openenergymonitor/emontx5/readme.md

# EmonTx5

EmonTx5, 6 channel energy monitoring transmitter based on emonPi2 measurement board.
