openenergymonitor/emontx5/docs/hardware.md

---
github_url: "https://github.com/openenergymonitor/emontx5/blob/main/docs/hardware.md"
---

# Hardware

The emonTx5 uses the same measurement board as the emonPi2. The only hardware differences are that the emonTx5 does not include the OLED display, push button, and an attached Raspberry Pi. Its radio module is configured through software to transmit data, rather than receive it, thereby making it an electricity monitoring transmitter node.

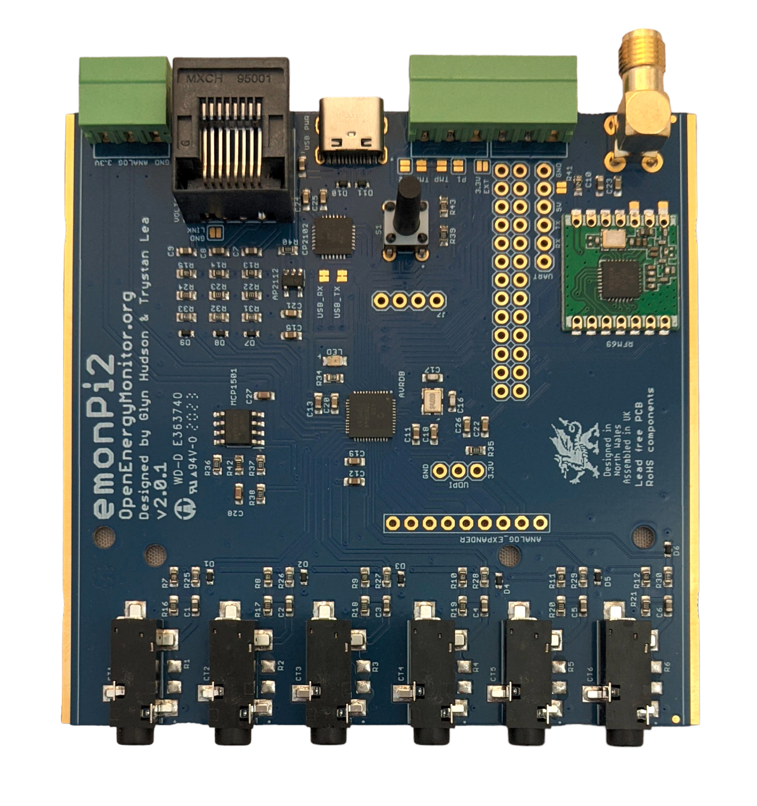
[picture p2: docs/img/emonpi2_board.jpg]


## Schematic

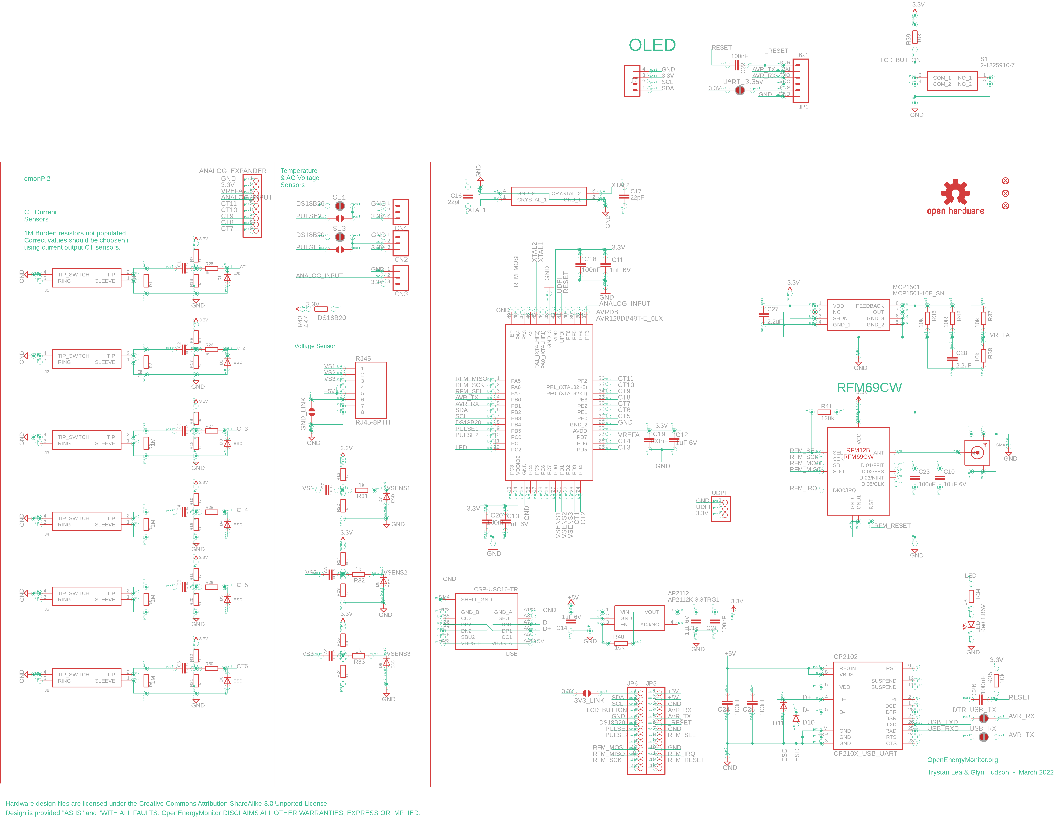
[picture p3: docs/img/schematic.png]


## Board layout

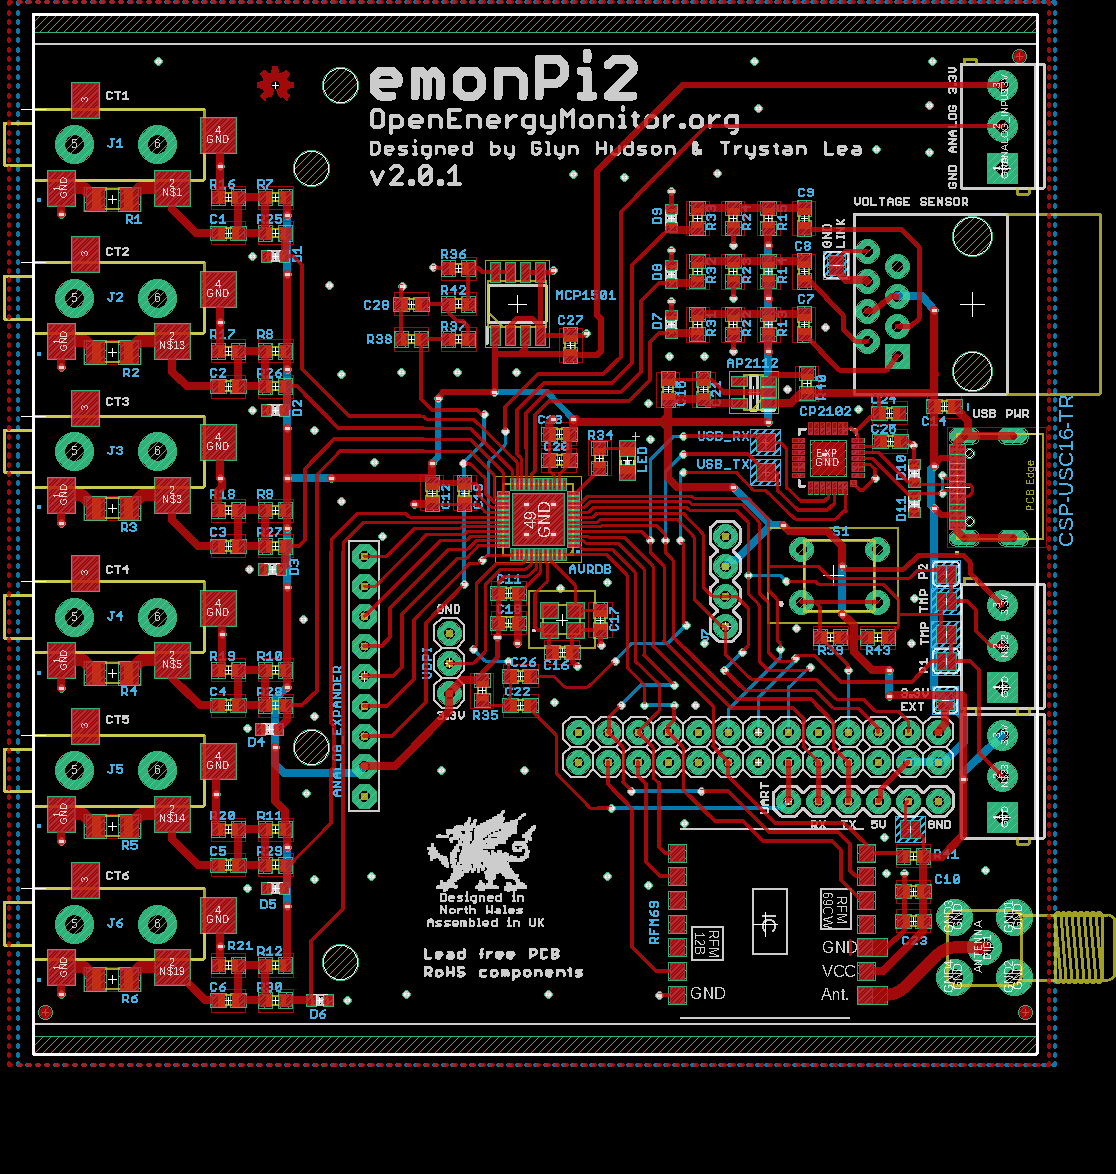
[picture p4: docs/img/board.png]


## Voltage sensor pinout

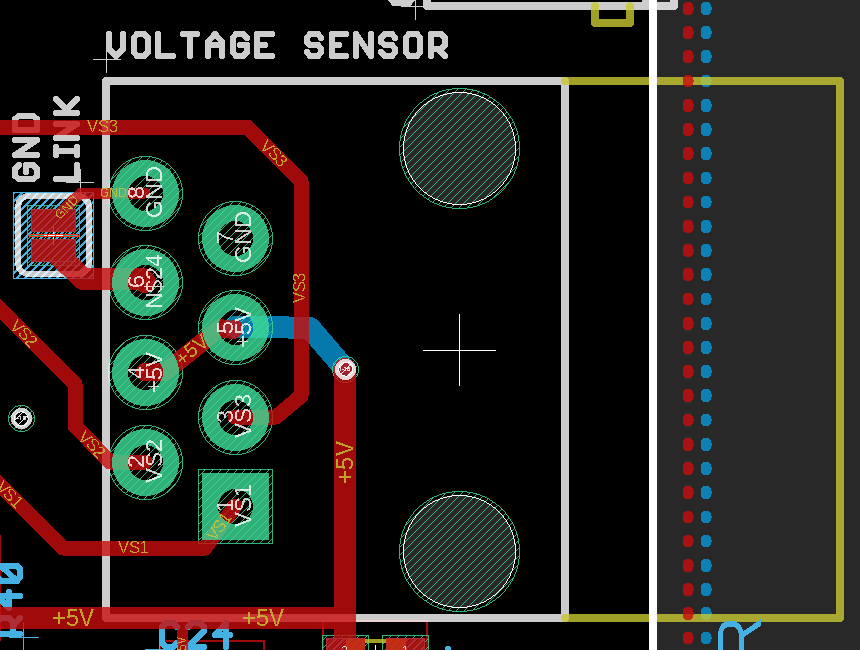
[picture p5: docs/img/emonPi2_voltage_sensor_pinout.png]


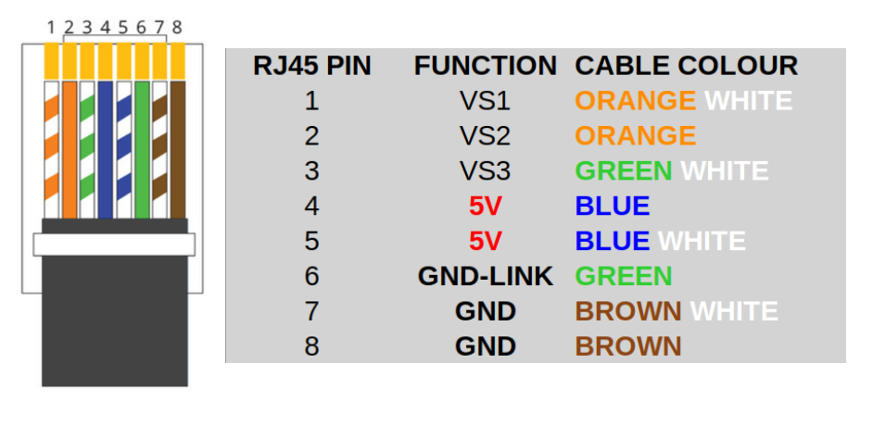
[picture p6: docs/img/emonPi2_emonvs_pinout.png]
