openenergymonitor/emontx5/docs/index.rst

emonTx5 User Guide
==================

.. toctree::
   :maxdepth: 2
   
   overview.md
   install.md
   firmware.md
   hardware.md
   Temperature, Pulse & Analog <other_sensors.md>
