openenergymonitor/emontx5/docs/img/emontx5_emonpi2.jpeg

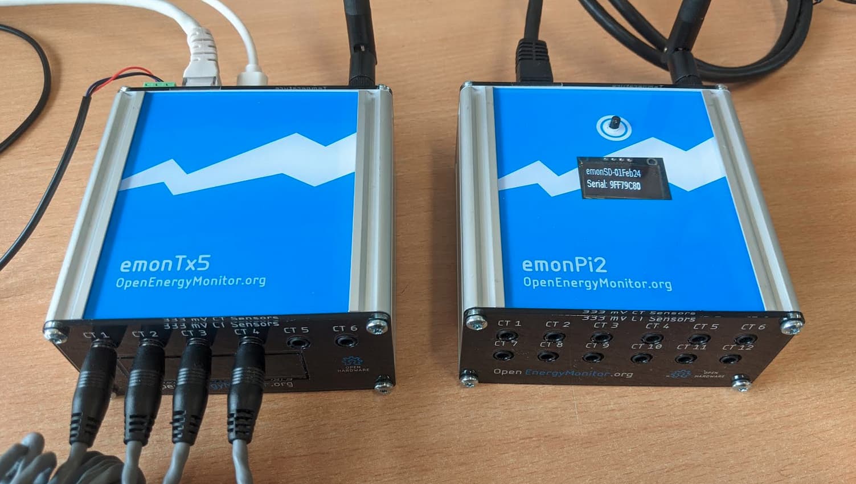
docs/img/emontx5_emonpi2.jpeg
