openenergymonitor/emontx5/docs/img/emonTx5_emonPi2_different_locations2.png

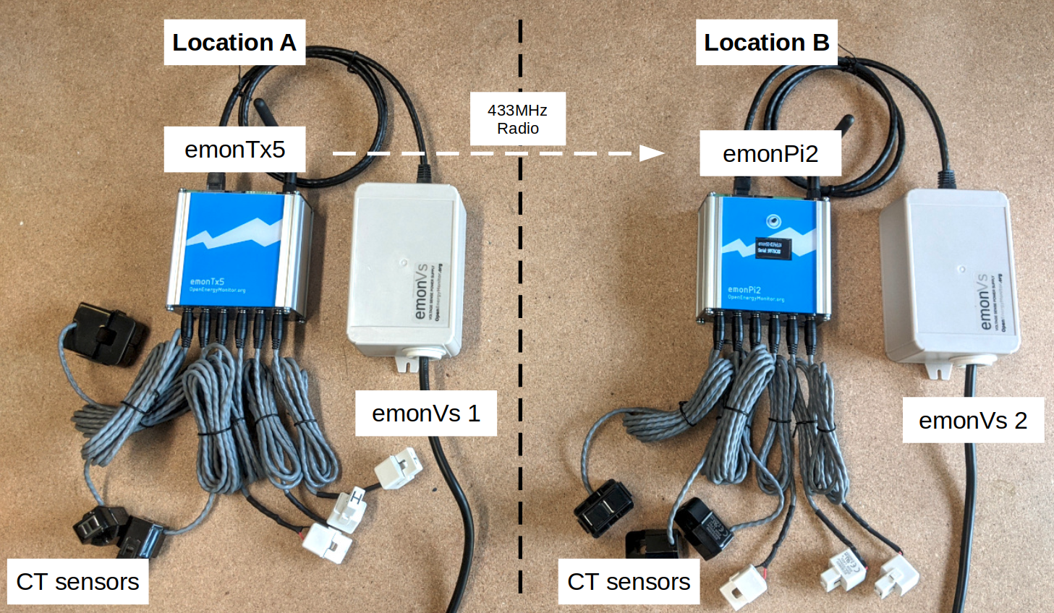
docs/img/emonTx5_emonPi2_different_locations2.png
