openenergymonitor/emontx5/(commit log)

2024-05-26 3-phase 4-wire and n,american systems
2024-06-03 other sensors
